cycfi/xr_spectra/hardware/preamp/decals/back.png

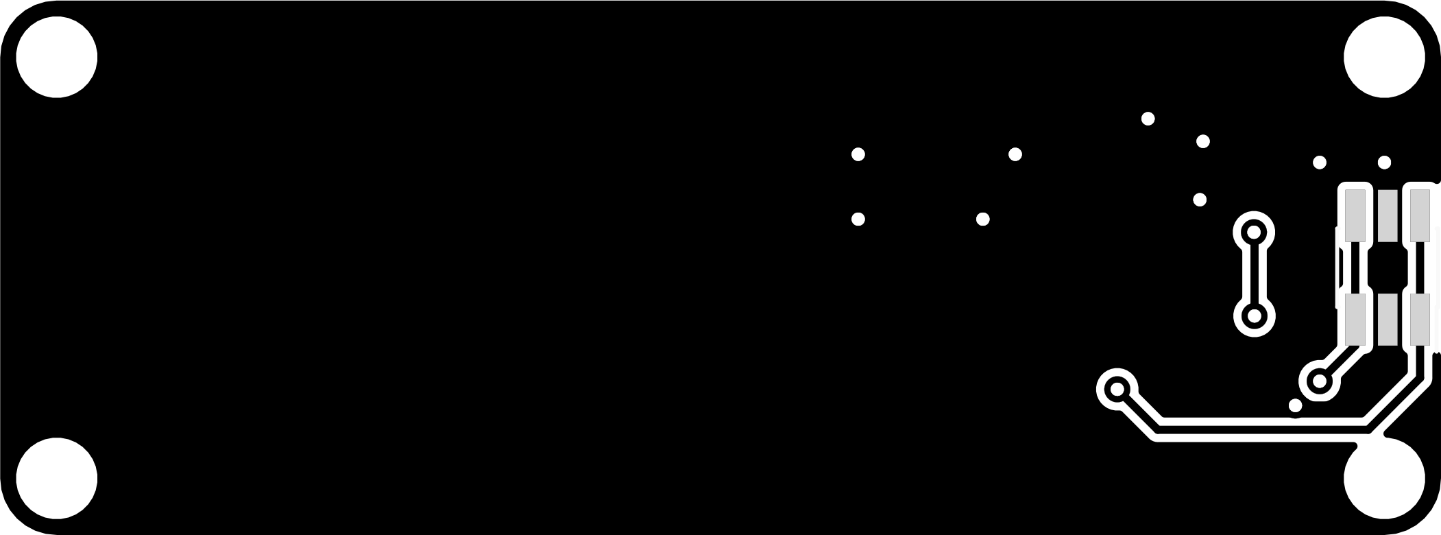
hardware/preamp/decals/back.png
