cycfi/xr_spectra/hardware/preamp/decals/front.png

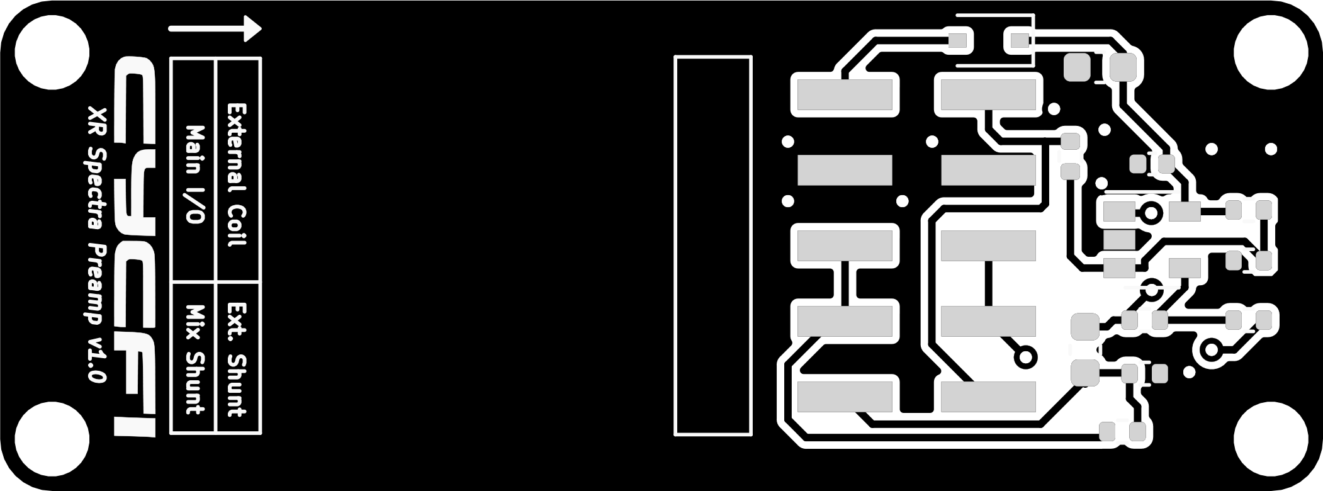
hardware/preamp/decals/front.png
