cycfi/xr_spectra/hardware/preamp/placement.png

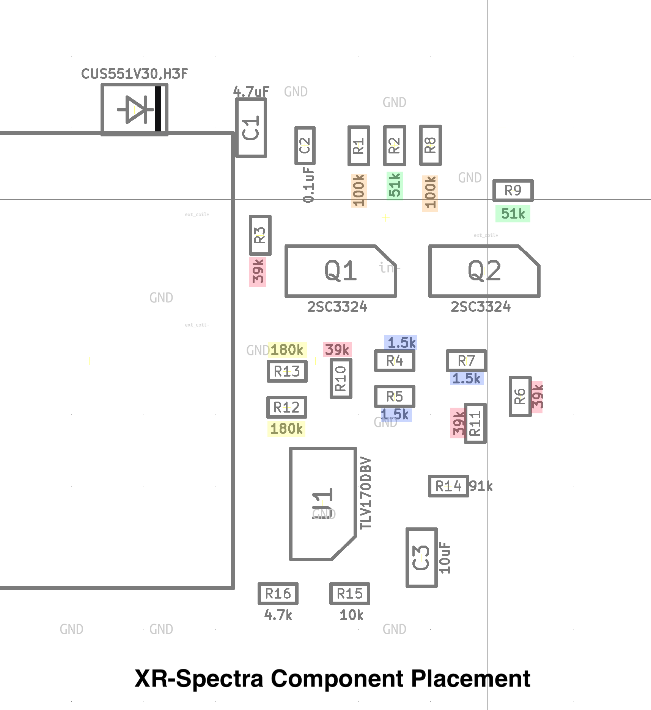
hardware/preamp/placement.png
