cycfi/xr_spectra/hardware/tone_block/3d/tone_block_top_decals.png

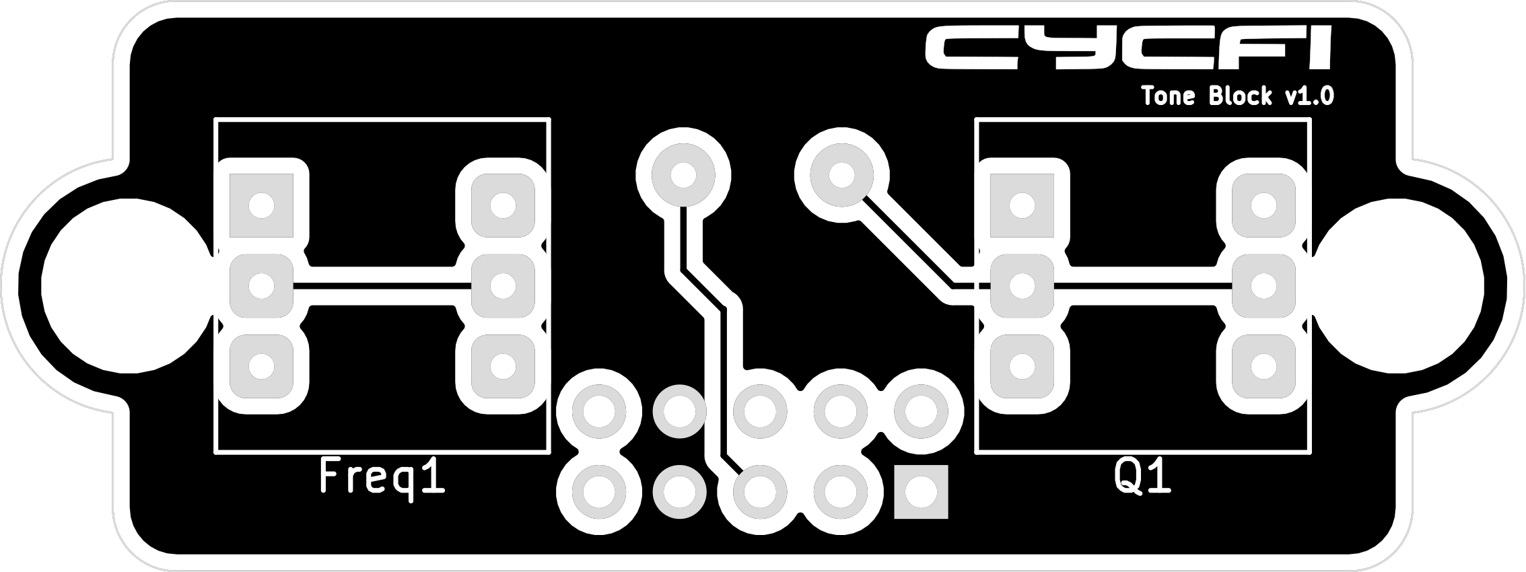
hardware/tone_block/3d/tone_block_top_decals.png
