cycfi/xr_spectra/hardware/tone_block/tone_block_bom.xlsx

Id | Designator | Package | Quantity | Designation | Supplier and ref
2 | J1 | pin_header_2x05_P2.54mm_vertical | 1 | I/O
4 | C1 | C_0402_1005Metric | 1 | 12nF
5 | C2 | C_0402_1005Metric | 1 | 27nF
6 | C3 | C_0402_1005Metric | 1 | 47nF
7 | C4 | C_0402_1005Metric | 1 | 100nF
8 | L1 | tb_inductor | 1 | 80mH
9 | R1 | R_0402_1005Metric | 1 | 1.33k
10 | R2 | R_0402_1005Metric | 1 | 665R
11 | R3 | R_0402_1005Metric | 1 | 330R
12 | R4 | R_0402_1005Metric | 1 | 165R
13 | R5 | R_0402_1005Metric | 1 | 82.5R
14 | R6 | R_0402_1005Metric | 1 | 4.7k
15 | Q1 | RS32716 | 1 | RS32716R
16 | Freq1 | RS32716 | 1 | RS32716C
