cycfi/xr_spectra/hardware/preamp/preamp_bom.xlsx

Designator | Package | Quantity | Designation
R16 | 0402 | 1 | 4.7k
R15 | 0402 | 1 | 10k
R14 | 0402 | 1 | 91k
R13,R12 | 0402 | 2 | 180k
R11,R10,R3,R6 | 0402 | 4 | 39k
R1,R8 | 0402 | 2 | 100k
R2,R9 | 0402 | 2 | 51k
R4,R5,R7 | 0402 | 3 | 1.5k
C1 | 0603 | 1 | 4.5uF
C3 | 0603 | 1 | 10uF
C2 | 0402 | 1 | 0.1uF
D1 | SOD-323 | 1 | CUS551V30,H3F
Q1,Q2 | SOT-23 | 2 | 2SC3324
U1 | SOT-23-5 | 1 | TLV170DBV
J1 | pin_header_2x5p_2.54mm_smd_horizontal | 1 | I/O
J2 | pin_socket_2x3p_1.00mm_smd_vertical | 1 | Conn 1
J3 | pin_socket_2x3p_1.00mm_smd_vertical | 1 | Conn 2
