cycfi/xr_spectra/hardware/dxf/xr2-3.3-top-bobbin-reference.DXF

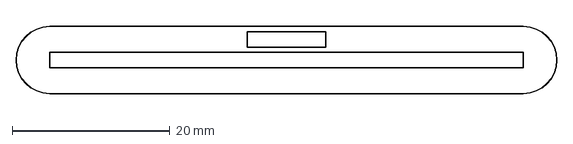
[picture p6: CAD file, 2021-08-13]
hardware/dxf/xr2-3.3-top-bobbin-reference.DXF
68.5 x 8.50 mm
