cycfi/xr_spectra/hardware/passive/passive.step

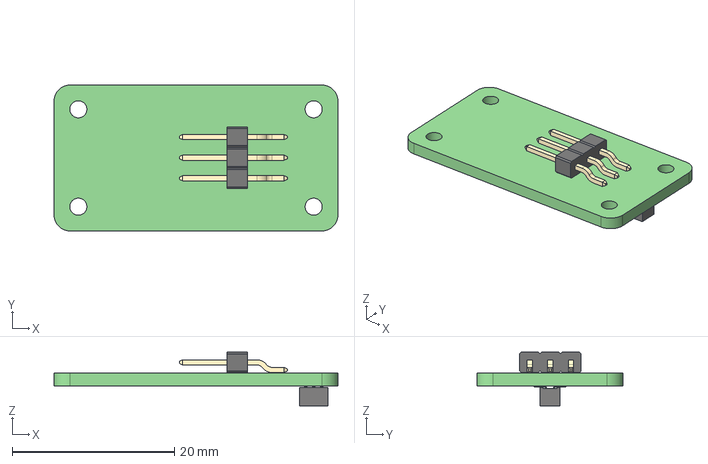
[picture p7: CAD file, 2021-06-28]
hardware/passive/passive.step
35.0 x 18.0 x 6.60 mm
