cycfi/xr_spectra/hardware/preamp/preamp.step

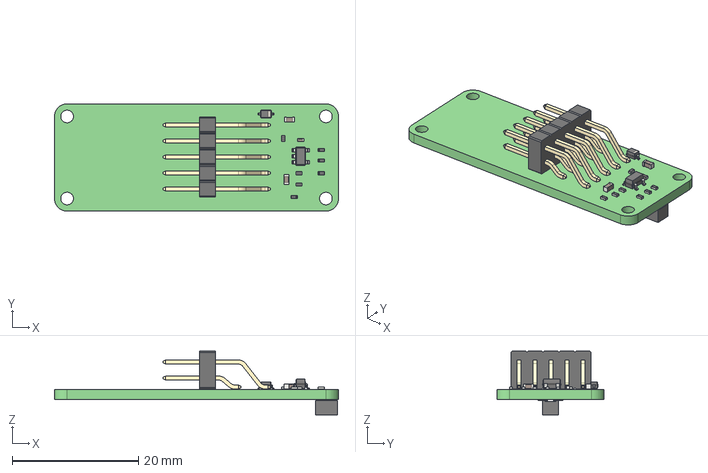
[picture p8: CAD file, 2021-06-28]
hardware/preamp/preamp.step
45.0 x 17.0 x 10.1 mm
