cycfi/xr_spectra/hardware/tone_block/3d/tone_block.step

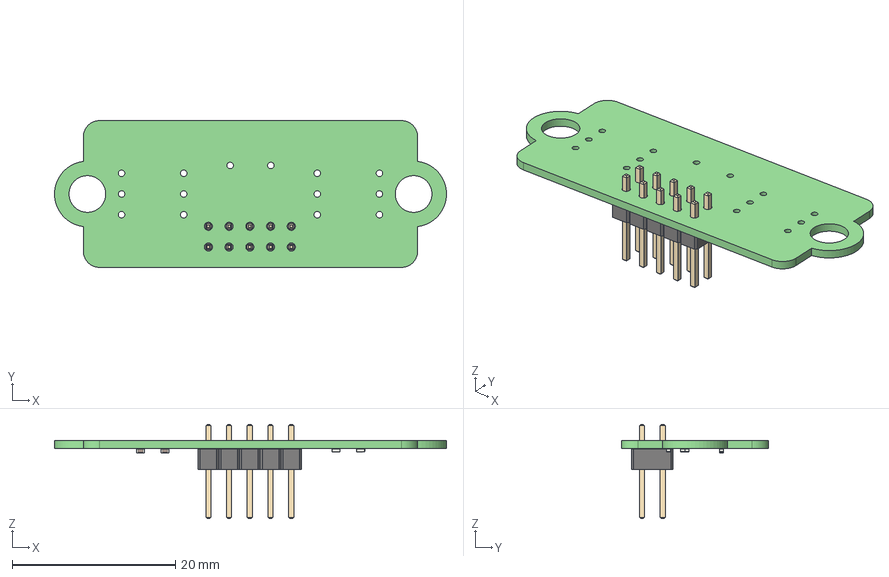
[picture p9: CAD file, 2021-09-10]
hardware/tone_block/3d/tone_block.step
48.1 x 18.0 x 11.5 mm
