cycfi/xr_spectra/hardware/dxf/xr2-3.3-bottom-bobbin-reference.DXF

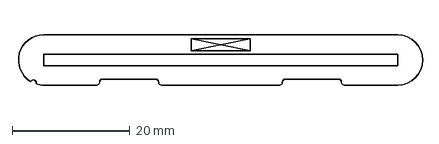
[picture p10: CAD file, 2021-08-13]
hardware/dxf/xr2-3.3-bottom-bobbin-reference.DXF
68.9 x 8.50 mm
