cycfi/xr_spectra/hardware/dxf/xr2-3.3-base1-pcb-reference.DXF

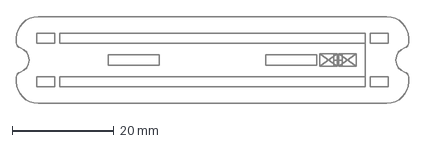
[picture p11: CAD file, 2021-08-10]
hardware/dxf/xr2-3.3-base1-pcb-reference.DXF
77.0 x 17.0 mm
