cycfi/xr_spectra/hardware/dxf/xr2-3.3-bottom-pcb.DXF

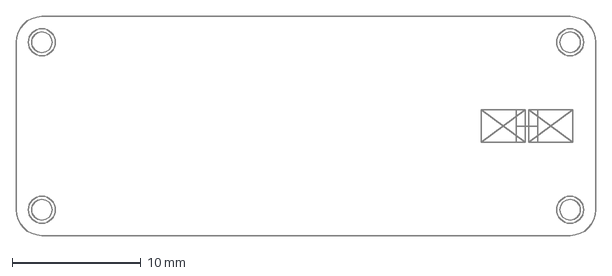
[picture p12: CAD file, 2021-08-10]
hardware/dxf/xr2-3.3-bottom-pcb.DXF
45.0 x 17.0 mm
