cycfi/xr_spectra/hardware/dxf/bobbin-top-3.3.DXF

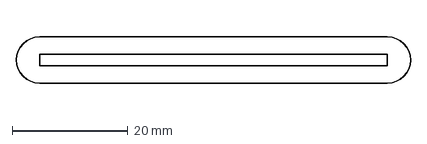
[picture p13: CAD file, 2021-06-28]
hardware/dxf/bobbin-top-3.3.DXF
68.0 x 8.00 mm
