cycfi/xr_spectra/hardware/passive/passive.pdf

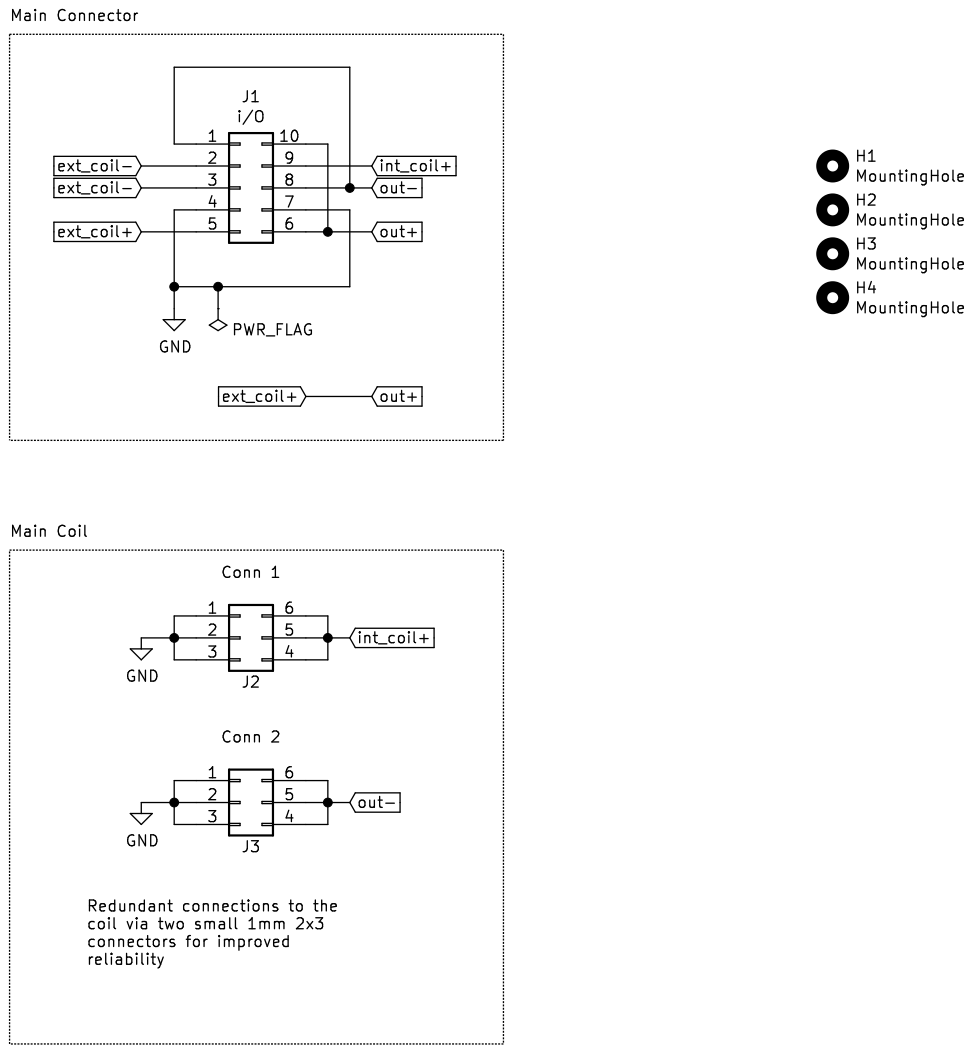
[picture p14: page 1]
