cycfi/xr_spectra/hardware/preamp/preamp.pdf

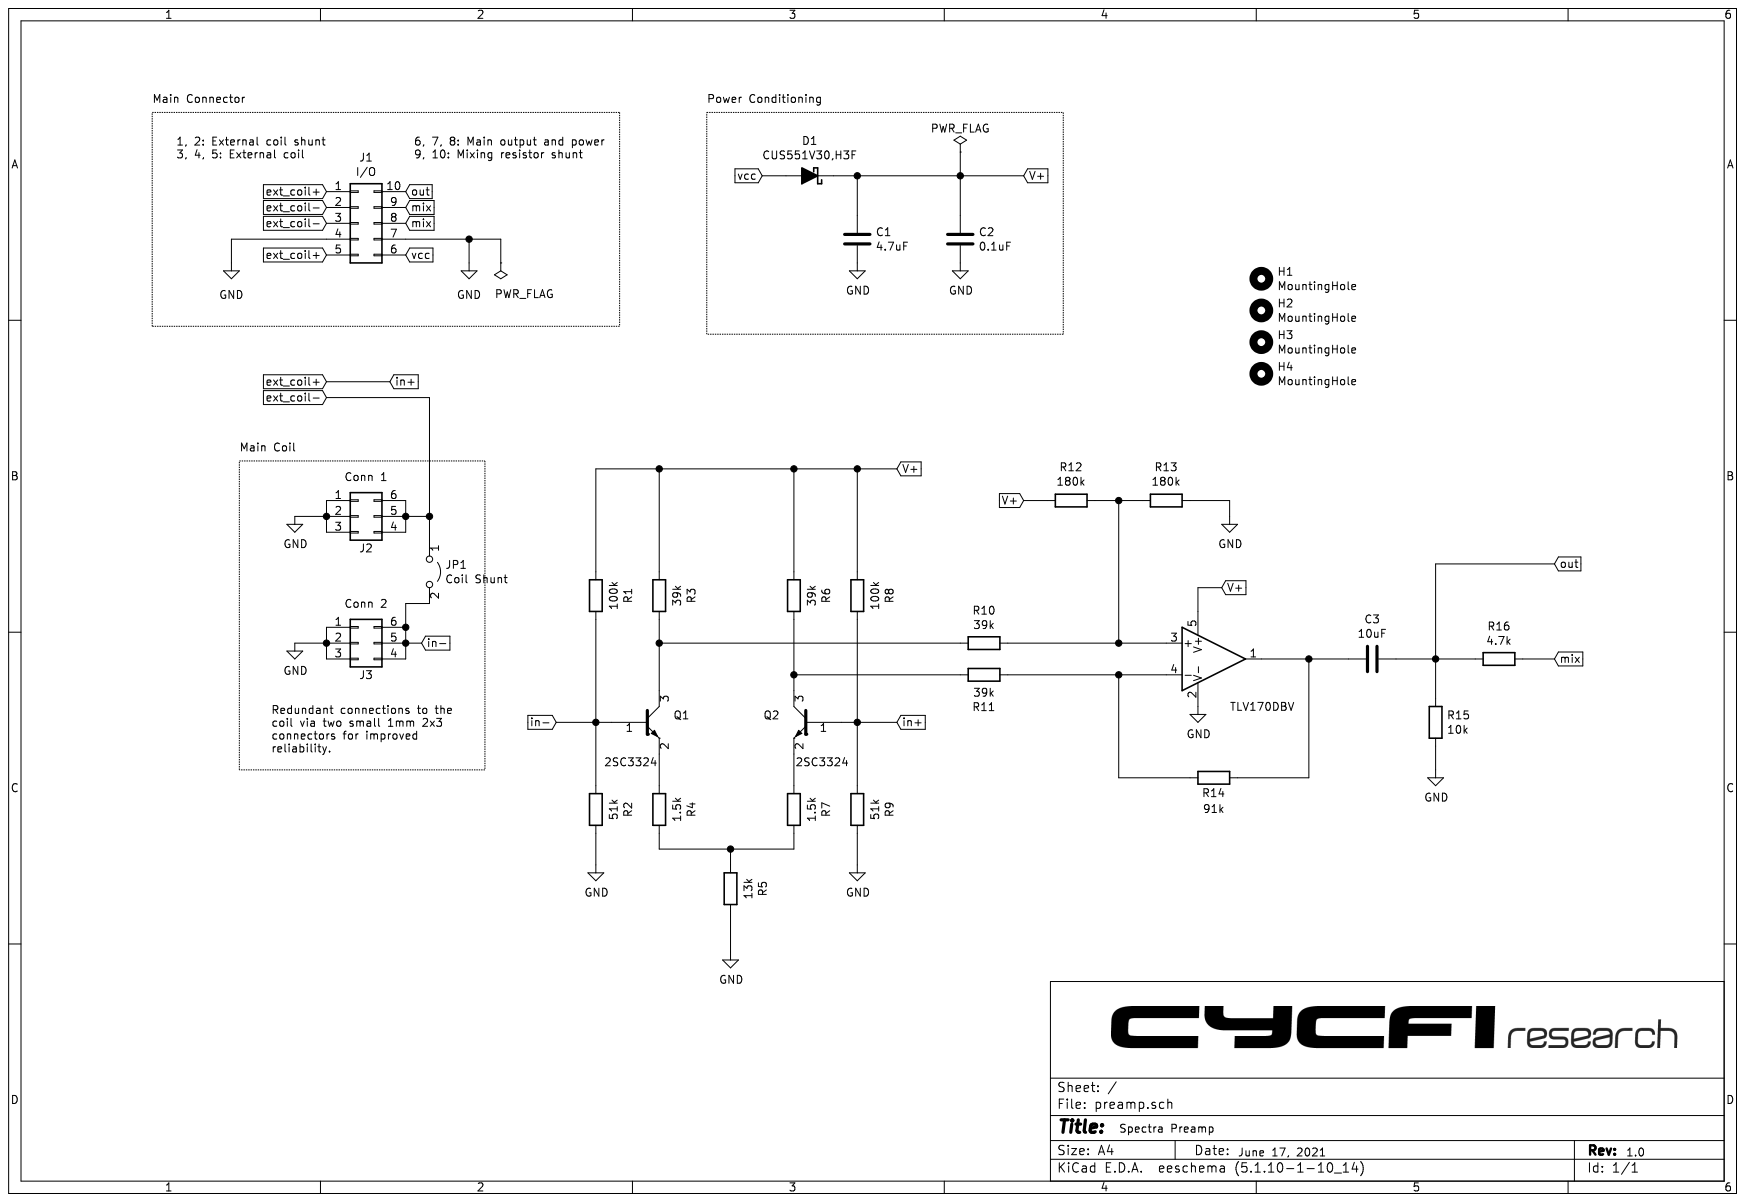
[picture p15: page 1]
