cycfi/xr_spectra/hardware/preamp/decals/preamp-B_Cu.pdf

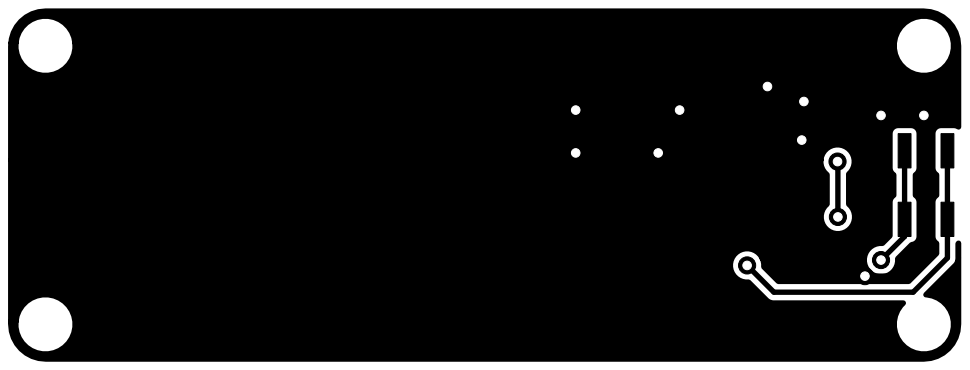
[picture p16: page 1]
