cycfi/xr_spectra/hardware/preamp/decals/preamp-B_Mask.pdf

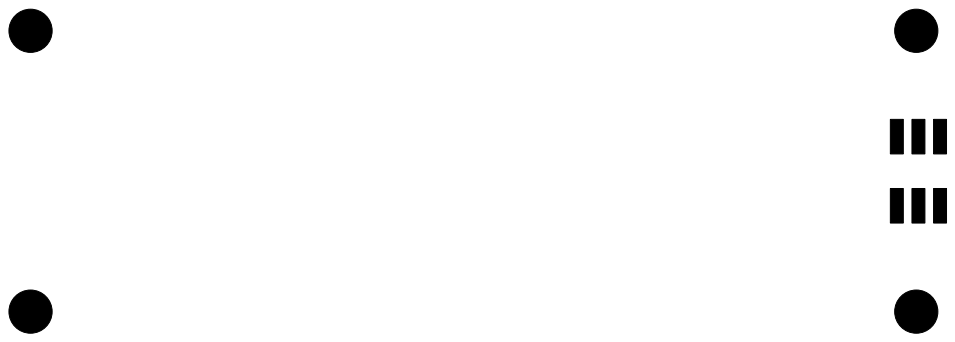
[picture p17: page 1]
