cycfi/xr_spectra/hardware/preamp/decals/preamp-B_SilkS.pdf

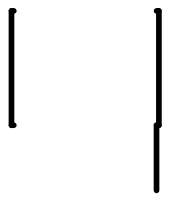
[picture p18: page 1]
