cycfi/xr_spectra/hardware/preamp/decals/preamp-F_Cu.pdf

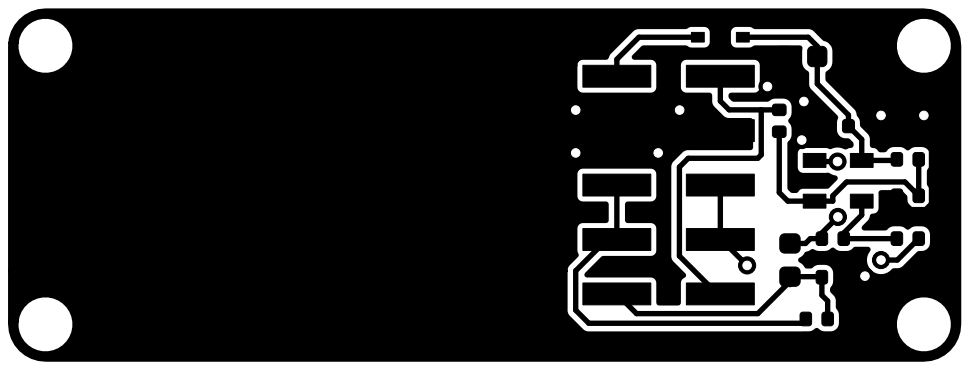
[picture p19: page 1]
