cycfi/xr_spectra/hardware/preamp/decals/preamp-F_Mask.pdf

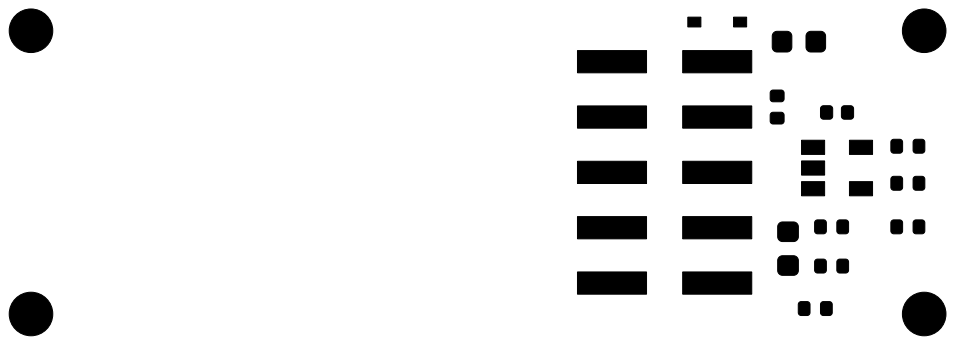
[picture p20: page 1]
