cycfi/xr_spectra/hardware/preamp/decals/preamp-F_SilkS.pdf

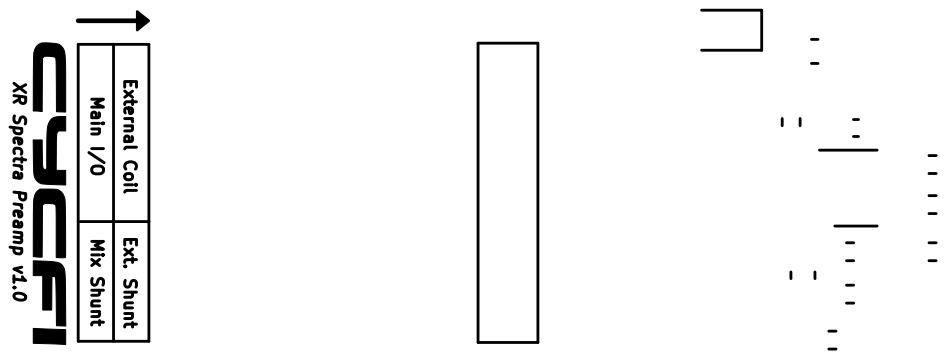
[picture p21: page 1]
