cycfi/xr_spectra/hardware/tone_block/tone_block.kicad_pcb

## KiCad design hardware/tone_block/tone_block.kicad_pcb (2021-10-09)

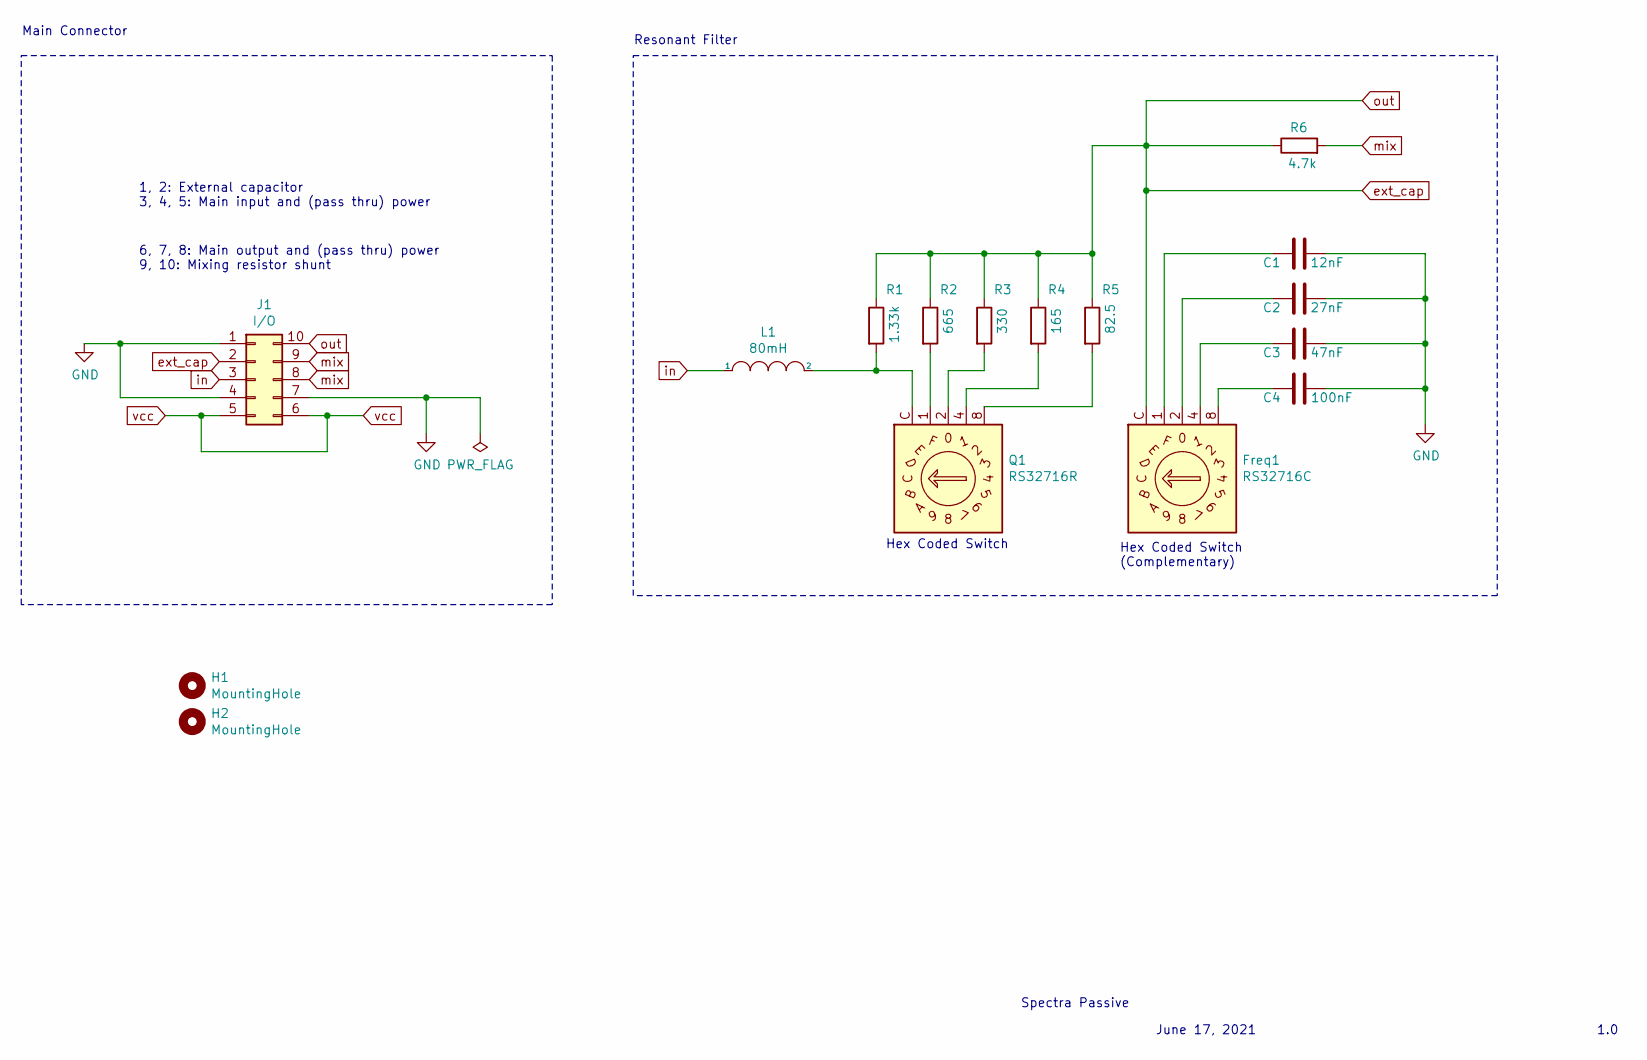
[picture p22: schematic tone_block.sch]

Parts:
C1: 12nF; C_0402_1005Metric
C2: 27nF; C_0402_1005Metric
C3: 47nF; C_0402_1005Metric
C4: 100nF; C_0402_1005Metric
Freq1: RS32716C; RS32716
H1, H2: MountingHole; self_clinching_m3
J1: I/O; pin_header_2x05_P2.54mm_vertical
L1: 80mH; tb_inductor
Q1: RS32716R; RS32716
R1: 1.33k; R_0402_1005Metric
R2: 665; R_0402_1005Metric
R3: 330; R_0402_1005Metric
R4: 165; R_0402_1005Metric
R5: 82.5; R_0402_1005Metric
R6: 4.7k; R_0402_1005Metric

Connections:
GND: C1.2, C2.1, C3.1, C4.1, J1.1, J1.4, J1.7
unnamed: C1.1, Freq1.1
unnamed: C2.2, Freq1.2
unnamed: C3.2, Freq1.4
unnamed: C4.2, Freq1.8
unnamed: L1.2, Q1.C, R1.2
unnamed: Q1.1, R2.2
unnamed: Q1.2, R3.2
unnamed: Q1.4, R4.2
unnamed: Q1.8, R5.2
ext_cap: Freq1.C, J1.2, J1.10, R1.1, R2.1, R3.1, R4.1, R5.1, R6.1
in: J1.3, L1.1
mix: J1.8, J1.9, R6.2
vcc: J1.5, J1.6

Notes on the sheet:
Spectra Passive
June 17, 2021
1.0
Resonant Filter
Hex Coded Switch
Hex Coded Switch (Complementary)
Main Connector
6, 7, 8: Main output and (pass thru) power 9, 10: Mixing resistor shunt
1, 2: External capacitor 3, 4, 5: Main input and (pass thru) power

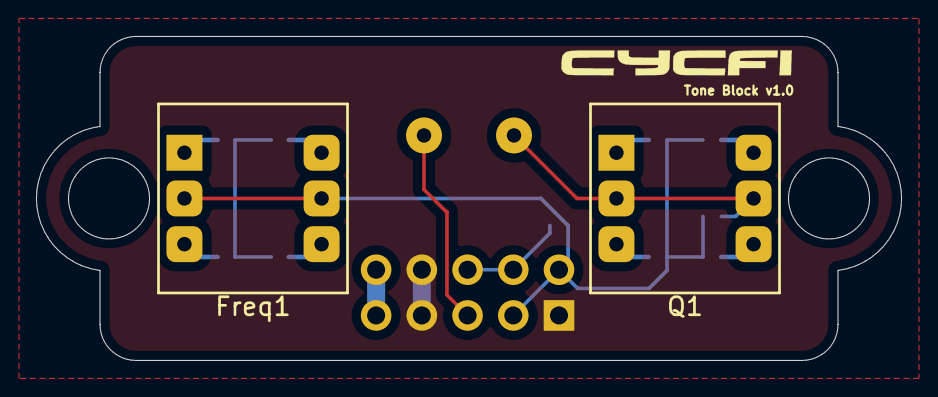
[picture p23: board tone_block.kicad_pcb from above]

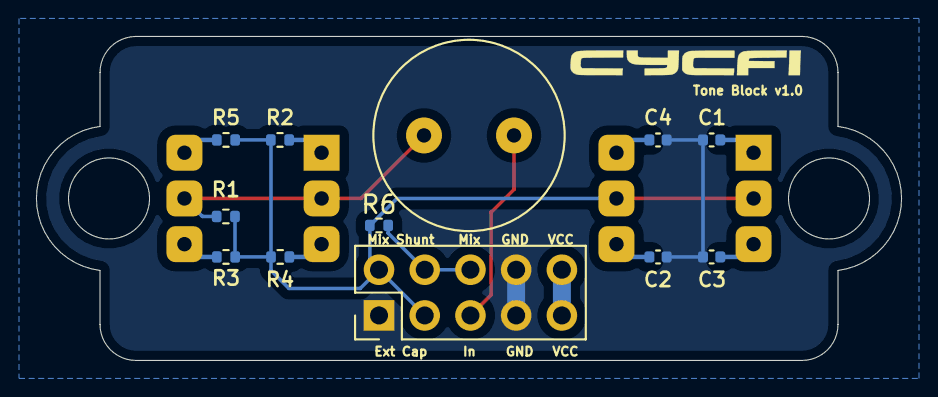
[picture p24: board tone_block.kicad_pcb from below]

Board: 2 copper layers, 48.1 x 18.0 mm, 16 parts (12 on the bottom side), 14 nets.
