cycfi/xr_spectra/hardware/passive/passive.kicad_pcb

## KiCad design hardware/passive/passive.kicad_pcb (2021-09-10)

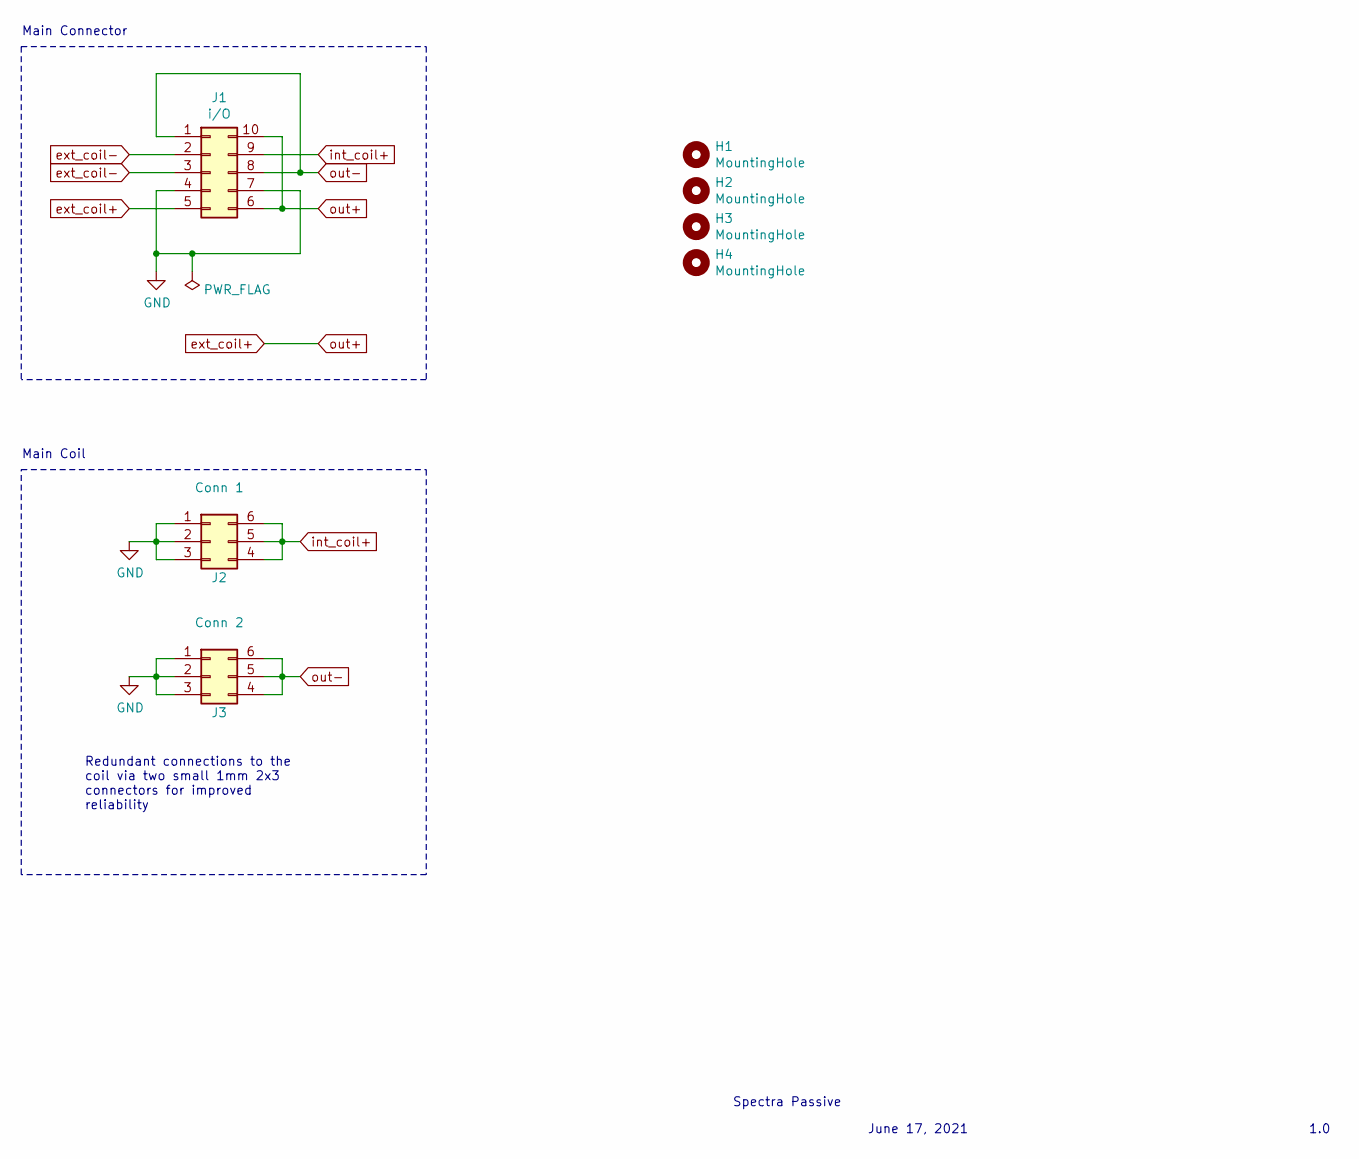
[picture p25: schematic passive.sch]

Parts:
H1, H2, H3, H4: MountingHole; mounting_hole_2.1mm
J1: i/O; pin_header_2x5p_2.54mm_smd_horizontal
J2: Conn 1; pin_socket_2x3p_1.00mm_smd_vertical
J3: Conn 2; pin_socket_2x3p_1.00mm_smd_vertical

Connections:
GND: J1.4, J1.7, J2.1, J2.2, J2.3, J3.1, J3.2, J3.3
ext_coil+: J1.5, J1.6, J1.10
ext_coil-: J1.2, J1.3
int_coil+: J1.9, J2.4, J2.5, J2.6
out-: J1.1, J1.8, J3.4, J3.5, J3.6

Notes on the sheet:
Spectra Passive
June 17, 2021
1.0
Main Coil
Main Connector
Redundant connections to the coil via two small 1mm 2x3 connectors for improved reliability

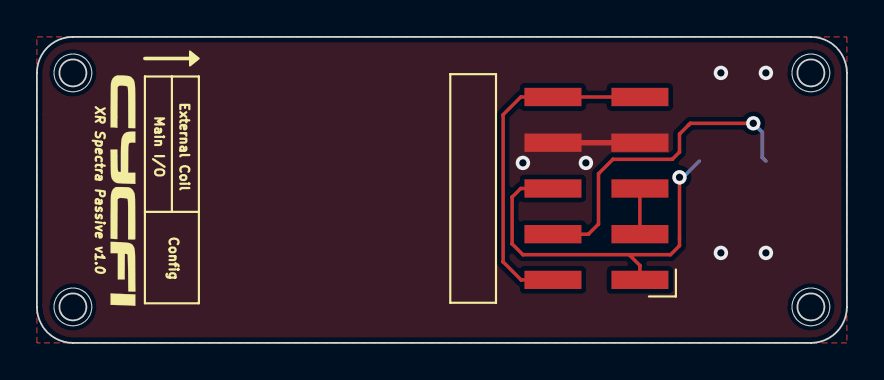
[picture p26: board passive.kicad_pcb from above]

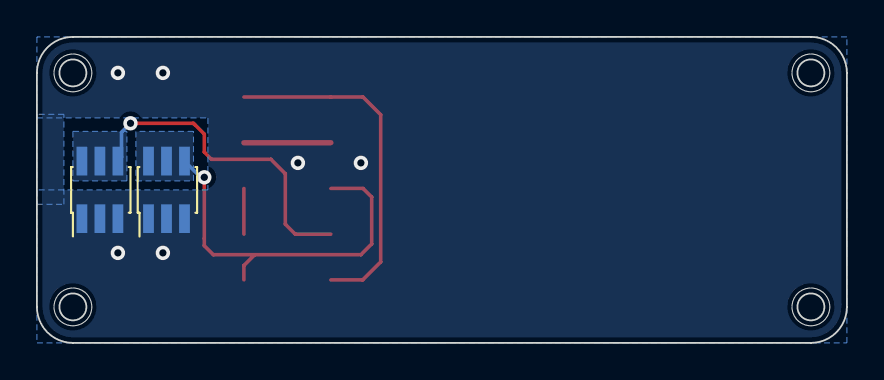
[picture p27: board passive.kicad_pcb from below]

Board: 2 copper layers, 45.0 x 17.0 mm, 7 parts (6 on the bottom side), 5 nets.
