cycfi/xr_spectra/hardware/preamp/preamp.kicad_pcb

## KiCad design hardware/preamp/preamp.kicad_pcb (2021-09-10)

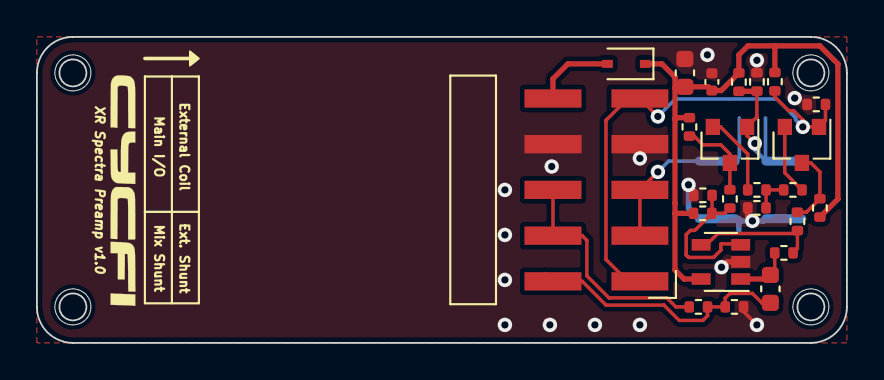
[picture p28: board preamp.kicad_pcb from above]

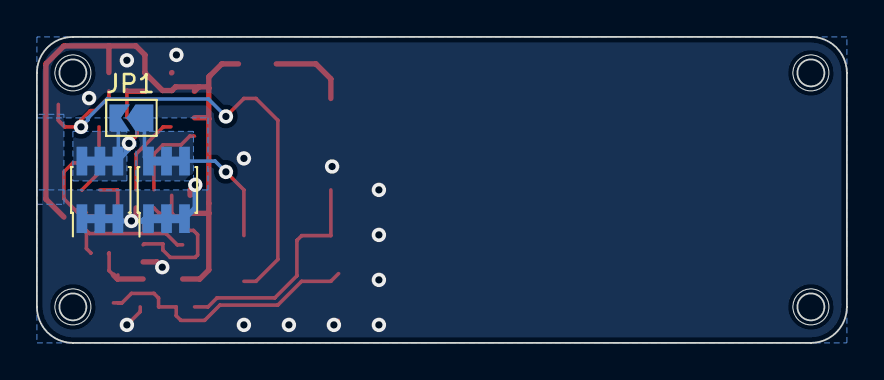
[picture p29: board preamp.kicad_pcb from below]

Board: 2 copper layers, 45.0 x 17.0 mm, 31 parts (7 on the bottom side), 16 nets.

Parts:
C1: 4.7uF; C_0603_1608Metric
C2: 0.1uF; C_0402_1005Metric
C3: 10uF; C_0603_1608Metric
D1: CUS551V30,H3F; D_SOD-323
H1, H2, H3, H4: MountingHole; mounting_hole_st1.9
J1: I/O; pin_header_2x5p_2.54mm_smd_horizontal
J2: Conn 1; pin_socket_2x3p_1.00mm_smd_vertical
J3: Conn 2; pin_socket_2x3p_1.00mm_smd_vertical
JP1: Coil Shunt; SolderJumper-2_P1.3mm_Open_TrianglePad1.0x1.5mm
Q1, Q2: 2SC3324; SOT-23
R1, R8: 100k; R_0402_1005Metric
R2, R9: 51k; R_0402_1005Metric
R3, R6, R10, R11: 39k; R_0402_1005Metric
R4, R7: 1.5k; R_0402_1005Metric
R5: 13k; R_0402_1005Metric
R12, R13: 180k; R_0402_1005Metric
R14: 91k; R_0402_1005Metric
R15: 10k; R_0402_1005Metric
R16: 4.7k; R_0402_1005Metric
U1: TLV170DBV; SOT-23-5

Connections:
GND: C1.2, C2.2, J1.4, J1.7, J2.1, J2.2, J2.3, J3.1, J3.2, J3.3, R2.1, R5.1, R9.1, R13.2, R15.2, U1.2
unnamed: C3.2, R14.2, U1.1
unnamed: Q1.2, R4.2
unnamed: Q1.3, R3.1, R10.2
unnamed: Q2.2, R7.2
unnamed: Q2.3, R6.1, R11.1
unnamed: R4.1, R5.2, R7.1
unnamed: R10.1, R12.2, R13.1, U1.3
unnamed: R11.2, R14.1, U1.4
V+: C1.1, C2.1, D1.1, R1.2, R3.2, R6.2, R8.2, R12.1, U1.5
ext_coil+: J1.1, J1.5, Q2.1, R8.1, R9.2
ext_coil-: J1.2, J1.3, J2.4, J2.5, J2.6, JP1.1
in-: J3.4, J3.5, J3.6, JP1.2, Q1.1, R1.1, R2.2
mix: J1.8, J1.9, R16.1
out: C3.1, J1.10, R15.1, R16.2
vcc: D1.2, J1.6
