cycfi/xr_spectra/hardware/base/base_4.0/base_4.0.kicad_pcb

## KiCad design hardware/base/base_4.0/base_4.0.kicad_pcb (2021-08-13)

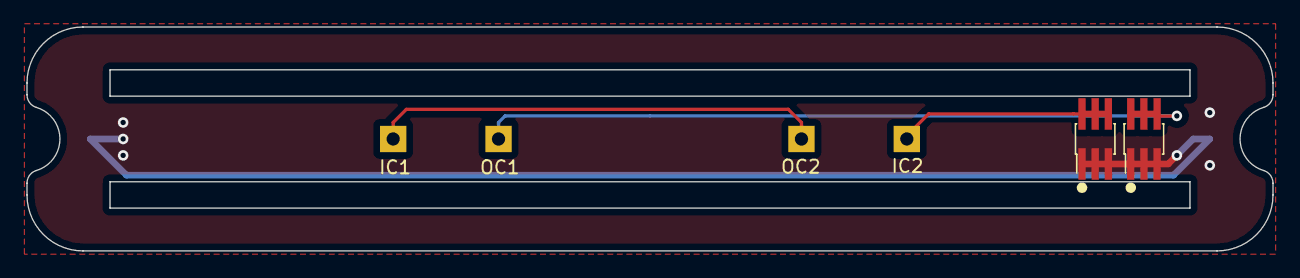
[picture p30: board base_4.0.kicad_pcb from above]

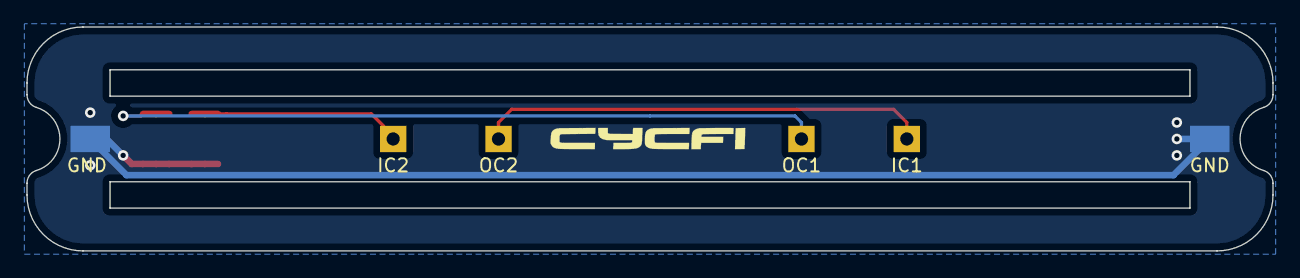
[picture p31: board base_4.0.kicad_pcb from below]

Board: 2 copper layers, 94.6 x 17.0 mm, 8 parts (6 on the bottom side), 4 nets.

Parts:
GND: single_pad_smd; single-pad-3x2
GND#2: single_pad_smd; single-pad-3x2
IC1, IC2: single_pad_smd; single-pad-2x2-th
J1: Conn 1; pin_header_2x3p_1.00mm_smd_vertical
J2: Conn 2; pin_header_2x3p_1.00mm_smd_vertical
OC1, OC2: single_pad_smd; single-pad-2x2-th

Connections:
/ic1: IC1.1, OC2.1
/ic2: IC2.1, J2.4, J2.5, J2.6
/oc1: J1.4, J1.5, J1.6, OC1.1
GND: GND.1, GND#2.1, J1.1, J1.2, J1.3, J2.1, J2.2, J2.3
