cycfi/xr_spectra/(commit log)

2021-06-18 Fully routed
    [spectra.kicad_pcb, spectra.sch]
2021-06-18 added logo
    [spectra.kicad_pcb]
2021-06-19 added 3d model for 2x5 pin header
    [spectra.kicad_pcb]
2021-06-19 - Increased PCB length to 50mm - Added legend
    [spectra.kicad_pcb]
2021-06-19 Nu name
    [spectra.kicad_pcb]
2021-06-25 Smaller board
    [spectra.kicad_pcb]
2021-06-25 improve the layout
    [spectra.kicad_pcb]
2021-06-26 added more GND vias
    [spectra.kicad_pcb]
2021-06-26 preamp updates/minor tweaks
    [preamp.kicad_pcb, preamp.sch]
2021-06-27 added passive board
    [passive.kicad_pcb, passive.sch]
2021-06-28 Added bottom bobbin for 3.3"
    [base1-3.3.DXF, bobbin-bottom-3.3.kicad_pcb, bobbin-bottom-3.3.sch, bobbin-top-3.3.DXF]
2021-06-28 Added step files
    [passive.step, preamp.step]
2021-06-28 Preamp updates
    [active-pcb-reference.DXF, preamp.kicad_pcb, preamp.sch, preamp.step]
2021-08-04 passive updates
    [passive.sch]
2021-08-08 - Updated schematics (added differntial pair) - Added component reference
    [preamp.sch]
2021-08-08 Updated PCB
    [preamp.kicad_pcb, preamp.sch]
2021-08-08 smaller by 5mm
    [preamp.kicad_pcb]
2021-08-08 update, optimize
    [preamp.kicad_pcb]
2021-08-08 Added coil jumper
    [preamp.kicad_pcb, preamp.sch]
2021-08-09 passive board v1.0
    [passive.kicad_pcb, passive.sch]
2021-08-10 Updated dxf reference file for placement verification
    [active-pcb-reference.DXF, preamp.kicad_pcb, xr2-3.3-bottom-pcb.DXF]
2021-08-10 WIP base board for 3.3"
    [base1-3.3.DXF, base_3.3.kicad_pcb, base_3.3.sch, xr2-3.3-base1-pcb-reference.DXF]
2021-08-10 Ok. Looks good.
    [base_3.3.kicad_pcb, base_3.3.sch]
2021-08-12 updates on grounding
    [base_3.3.kicad_pcb, base_3.3.sch]
2021-08-13 base board xr-spectra v1.0
    [base_3.3.kicad_pcb, base_3.3.sch]
2021-08-13 Added 3.5" variant
    [base_3.5.kicad_pcb, base_3.5.sch]
2021-08-13 Added 4.0 version
    [base_4.0.kicad_pcb, base_4.0.sch]
2021-08-13 Updated bobbin-bottom
    [bobbin-bottom-3.3.kicad_pcb, bobbin-bottom-3.3.sch, xr2-3.3-bottom-bobbin-reference.DXF, xr2-3.3-top-bobbin-reference.DXF]
2021-08-13 Added bobbin-bottom
    [bobbin_bottom_3.3.kicad_pcb, bobbin_bottom_3.3.sch, bobbin_top_3.3.kicad_pcb, bobbin_top_3.3.sch]
2021-08-14 Change graphic line widths to 0.05
    [bobbin_bottom_3.3.kicad_pcb]
2021-08-14 bottom bobbin for 3.5
    [bobbin_bottom_3.5.kicad_pcb, bobbin_bottom_3.5.sch]
2021-08-14 Correct pad layers
    [bobbin_bottom_3.3.kicad_pcb, bobbin_top_3.3.kicad_pcb]
2021-08-14 Added 3.5 and 4.0 versions (top and bottom bobbins)
    [bobbin_bottom_4.0.kicad_pcb, bobbin_bottom_4.0.sch, bobbin_top_3.5.kicad_pcb, bobbin_top_3.5.sch, bobbin_top_4.0.kicad_pcb, bobbin_top_4.0.sch]
2021-08-17 WIP tone block
    [tone_block.kicad_pcb, tone_block.sch]
2021-08-17 layout updates
    [tone_block.kicad_pcb]
2021-08-17 Fix mistake
    [tone_block.kicad_pcb, tone_block.sch]
2021-08-18 Some more tweaks
    [tone_block.kicad_pcb]
2021-08-18 panelized base 3.3
    [base_3.3.kicad_pcb, base_3.3_panel.kicad_pcb]
2021-08-18 base for 3.5" and 4.0"
    [base_3.5.kicad_pcb, base_3.5_panel.kicad_pcb, base_4.0_panel.kicad_pcb]
2021-08-18 base 3.3 and 4.0 panels
    [base_3.3_panel.kicad_pcb, base_3.5_panel.kicad_pcb, base_4.0_panel.kicad_pcb]
2021-08-18 bobbin 3.3 and 3.5
    [bobbin_3.3_panel.kicad_pcb, bobbin_3.5_panel.kicad_pcb, bobbin_4.0_panel.kicad_pcb]
2021-08-18 Passive and Active board panels
    [passive_panel.kicad_pcb, preamp_panel.kicad_pcb]
2021-08-18 Tone Block Panel
    [tone_block_panel.kicad_pcb]
2021-08-18 Wider breakaway tabs
    [tone_block_panel.kicad_pcb]
2021-08-19 Preamp, Tone Block, Passive, and Bobbin Panel updates
    [bobbin_3.3_panel.kicad_pcb, bobbin_3.5_panel.kicad_pcb, bobbin_4.0_panel.kicad_pcb, bobbin_bottom_3.3.kicad_pcb, bobbin_bottom_3.5.kicad_pcb, bobbin_bottom_4.0.kicad_pcb, passive_panel.kicad_pcb, preamp_panel.kicad_pcb]
2021-08-19 Base PCB panels updates
    [base_3.3_panel.kicad_pcb, base_3.5_panel.kicad_pcb, base_4.0_panel.kicad_pcb]
2021-08-19 Moved to pcb_private repo
    [base_3.3_panel.kicad_pcb, base_3.5_panel.kicad_pcb, base_4.0_panel.kicad_pcb, bobbin_3.3_panel.kicad_pcb, bobbin_3.5_panel.kicad_pcb, bobbin_4.0_panel.kicad_pcb, passive_panel.kicad_pcb, preamp_panel.kicad_pcb]
2021-09-06 Added BOM
    [preamp_bom.xlsx, tone_block.xlsx]
2021-09-06 Added preamp component placement
    [preamp.kicad_pcb, preamp.sch]
2021-09-07 fixed wrong resistor value
    [preamp.kicad_pcb, preamp.sch]
2021-09-10 3D rendering assets
    [passive.kicad_pcb, preamp.kicad_pcb, tone_block.csv, tone_block.kicad_pcb, tone_block.step]
2021-09-25 Preamp and toneblock updates
    [preamp.kicad_pcb, preamp.sch, tone_block.kicad_pcb, tone_block.sch]
2021-09-25 tone block updates
    [tone_block.kicad_pcb]
2021-09-25 Tone block updated from comments
    [tone_block.kicad_pcb]
2021-10-02 pdf capture of schematics
2021-10-08 Updated gain
    [preamp.sch]
2021-10-09 rename for consistency
    [tone_block_bom.xlsx]
2022-02-24 Commit gerbers
    [base_3.3-CmtUser.gbr, base_3.3-CuBottom.gbr, base_3.3-CuTop.gbr, base_3.3-EdgeCuts.gbr, base_3.3-MaskBottom.gbr, base_3.3-MaskTop.gbr, base_3.3-PasteBottom.gbr, base_3.3-PasteTop.gbr]
